nedap/retail-smartdeactivator-SD04/README.md

# Smart Deactivator SD04 Hardware

The is a repo to create anew hardware version of the Smart Deactivator

## Eda Package

* Kicad 9.0.0

https://www.kicad.org/download/
