nedap/retail-smartdeactivator-SD04/(commit log)

2025-03-18 Update schematic
    Error in HV-Conv FB network
    [HV-Generator.kicad_sch]
2025-03-18 Update component values
    Update values in the HV Converter schematic
    [HV-Generator.kicad_sch]
2025-03-28 Small schematic changes
    Moved R13, added some alternative parts
    [HV-Generator.kicad_sch, VCO.kicad_sch]
2025-04-10 Added transistor for enable_disable HV generator
    [HV-Generator.kicad_sch]
2025-05-27 Added PLL
    Added PLL, power supplies started, Microcontroller Started
    [HV-Generator.kicad_sch, Microcontroller.kicad_sch, PowerSupp.kicad_sch, SD04Proto.kicad_sch, VCO.kicad_sch]
2025-06-10 Added PCB Data
    [PowerSupp.kicad_sch, Receive.kicad_sch, SD04Proto.kicad_pcb, SD04Proto.kicad_sch, Transmit.kicad_sch, VCO.kicad_sch, bottom_old.kicad_pcb]
2025-06-10 added enable switch and load, boostconverter
    [HV-Generator.kicad_sch, PowerSupp.kicad_sch, VCO.kicad_sch]
2025-06-12 modified schematic to match current proto
    [HV-Generator.kicad_sch, Microcontroller.kicad_sch]
2025-06-12 updated with current extern input
    [Microcontroller.kicad_sch, PowerSupp.kicad_sch, SD04Proto.kicad_sch]
2025-06-12 added extern input sheet
    [Extern-Input.kicad_sch]
2025-06-13 Worked further on the microcontroller and Extern interface
    [Extern-Input.kicad_sch, HV-Generator.kicad_sch, Microcontroller.kicad_sch, SD04Proto.kicad_sch]
2025-06-17 Added receiver to schematic
    [Extern-Input.kicad_sch, Microcontroller.kicad_sch, Receive.kicad_sch, SD04Proto.kicad_sch, Transmit.kicad_sch]
2025-06-24 Made boost converter layout
    [Boost_converter.kicad_pcb, Boost_converter.kicad_sch, Microcontroller.kicad_sch, Power_supply.kicad_sch, boost.kicad_sch]
2025-06-30 updated layout after review
    [Boost_converter.kicad_pcb, Power_supply.kicad_sch, boost.kicad_sch]
2025-07-03 Changed mosfet schematic symbol
    [Boost_converter.kicad_pcb, boost.kicad_sch]
2025-07-04 added testpoints
    [Extern-Input.kicad_sch, Microcontroller.kicad_sch, PowerSupp.kicad_sch, SD04Proto.kicad_sch]
2025-07-04 changed the layout after review
    [Boost_converter.kicad_pcb, Boost_converter.kicad_sch]
